Fengling-Tech-Co-Ltd/kicad_integrating_box_light_source/BOM_立创编号.csv

Refs | Qty | Value | Footprint | LCSC Part | MPN
C1,C2,C3,C4,C7 | 5 | 10u/50V | Capacitor_SMD:C_1206_3216Metric | (未填) | 10u/50V
C8,C11,C12,C15,C16 | 5 | 100n | Capacitor_SMD:C_0603_1608Metric | (未填) | 100n
C9 | 1 | 1u/50V | Capacitor_SMD:C_0805_2012Metric | (未填) | 1u/50V
C10 | 1 | 10u/16V | Capacitor_SMD:C_0805_2012Metric | (未填) | 10u/16V
C13 | 1 | 1u | Capacitor_SMD:C_0603_1608Metric | (未填) | 1u
C14 | 1 | 10p | Capacitor_SMD:C_0603_1608Metric | (未填) | 10p
D1 | 1 | BPW34S-SMD | OptoDevice:Osram_BPW34S-SMD | C145262 | BPW34S-SMD
D6,D11,D16,D21 | 4 | SS34 | Diode_SMD:D_SMB | (未填) | SS34
D22 | 1 | SMBJ30CA | Diode_SMD:D_SMB | (未填) | SMBJ30CA
D24 | 1 | SS54 | Diode_SMD:D_SMB | (未填) | SS54
F1 | 1 | 2A/125V | Fuse:Fuse_1206_3216Metric | (未填) | 2A/125V
H1,H2,H3,H4 | 4 | MountingHole | MountingHole:MountingHole_2.2mm_M2 | (未填) | MountingHole
J1 | 1 | Conn_01x02_焊线焊盘 | Connector_Wire:SolderWire-0.5sqmm_1x02_P4.6mm_D0.9mm_OD2.1mm | (未填) | Conn_01x02_焊线焊盘
J2 | 1 | Conn_01x03_焊线焊盘 | Connector_Wire:SolderWire-0.25sqmm_1x03_P4.2mm_D0.65mm_OD1.7mm | (未填) | Conn_01x03_焊线焊盘
J3,J4 | 2 | FPC_0.5mm_4P_卧贴 | integrating_box_light_source:HC-FPC-05-09-4RLTAG | C5213746 | FPC_0.5mm_4P_卧贴
L1,L2,L3,L4 | 4 | 100uH | Inductor_SMD:L_1210_3225Metric | (未填) | 100uH
LED_B1,LED_B2,LED_B3,LED_B4 | 4 | XL-HD3535UBC-A2 | integrating_box_light_source:LED_3535_3500x3500mm | C3646953 | XL-HD3535UBC-A2
LED_G1,LED_G2,LED_G3,LED_G4 | 4 | JNJ-LEHG0113W120 | integrating_box_light_source:LED_3535_3500x3500mm | C19185875 | JNJ-LEHG0113W120
LED_IR1,LED_IR2,LED_IR3,LED_IR4 | 4 | XL-HD3535HIR-T4A2 | integrating_box_light_source:LED_3535_3500x3500mm | C5221244 | XL-HD3535HIR-T4A2
LED_R1,LED_R2,LED_R3,LED_R4 | 4 | XL-HD3535SURC-A2 | integrating_box_light_source:LED_3535_3500x3500mm | C3646952 | XL-HD3535SURC-A2
R1,R2,R3,R4 | 4 | R30 | Resistor_SMD:R_1206_3216Metric | (未填) | R30
R6 | 1 | 240 | Resistor_SMD:R_0603_1608Metric | (未填) | 240
R7 | 1 | 390 | Resistor_SMD:R_0603_1608Metric | (未填) | 390
R8 | 1 | 470 | Resistor_SMD:R_0603_1608Metric | (未填) | 470
R9,R10 | 2 | 4k7 | Resistor_SMD:R_0603_1608Metric | (未填) | 4k7
R11 | 1 | 47k | Resistor_SMD:R_0603_1608Metric | (未填) | 47k
U1 | 1 | ADS1110 | Package_TO_SOT_SMD:SOT-23-6 | (未填) | ADS1110
U2 | 1 | OPA333xxDBV | Package_TO_SOT_SMD:SOT-23-5 | (未填) | OPA333xxDBV
U3 | 1 | MCP4728 | Package_SO:MSOP-10_3x3mm_P0.5mm | (未填) | MCP4728
U4 | 1 | AL8862SP-13 | Package_SO:SOIC-8-1EP_3.9x4.9mm_P1.27mm_EP2.41x3.3mm_ThermalVias | C526360 | AL8862SP-13
U5,U6,U7 | 3 | AL8862SP-13 | Package_SO:SOIC-8-1EP_3.9x4.9mm_P1.27mm_EP2.41x3.3mm | C526360 | AL8862SP-13
U10 | 1 | LM317 | Package_TO_SOT_SMD:TO-252-2 | (未填) | LM317
